ashleyjr/IceDAC/hardware/rev_a/IceDAC/IceDAC.kicad_pcb

## KiCad design hardware/rev_a/IceDAC/IceDAC.kicad_pcb (2024-07-18)

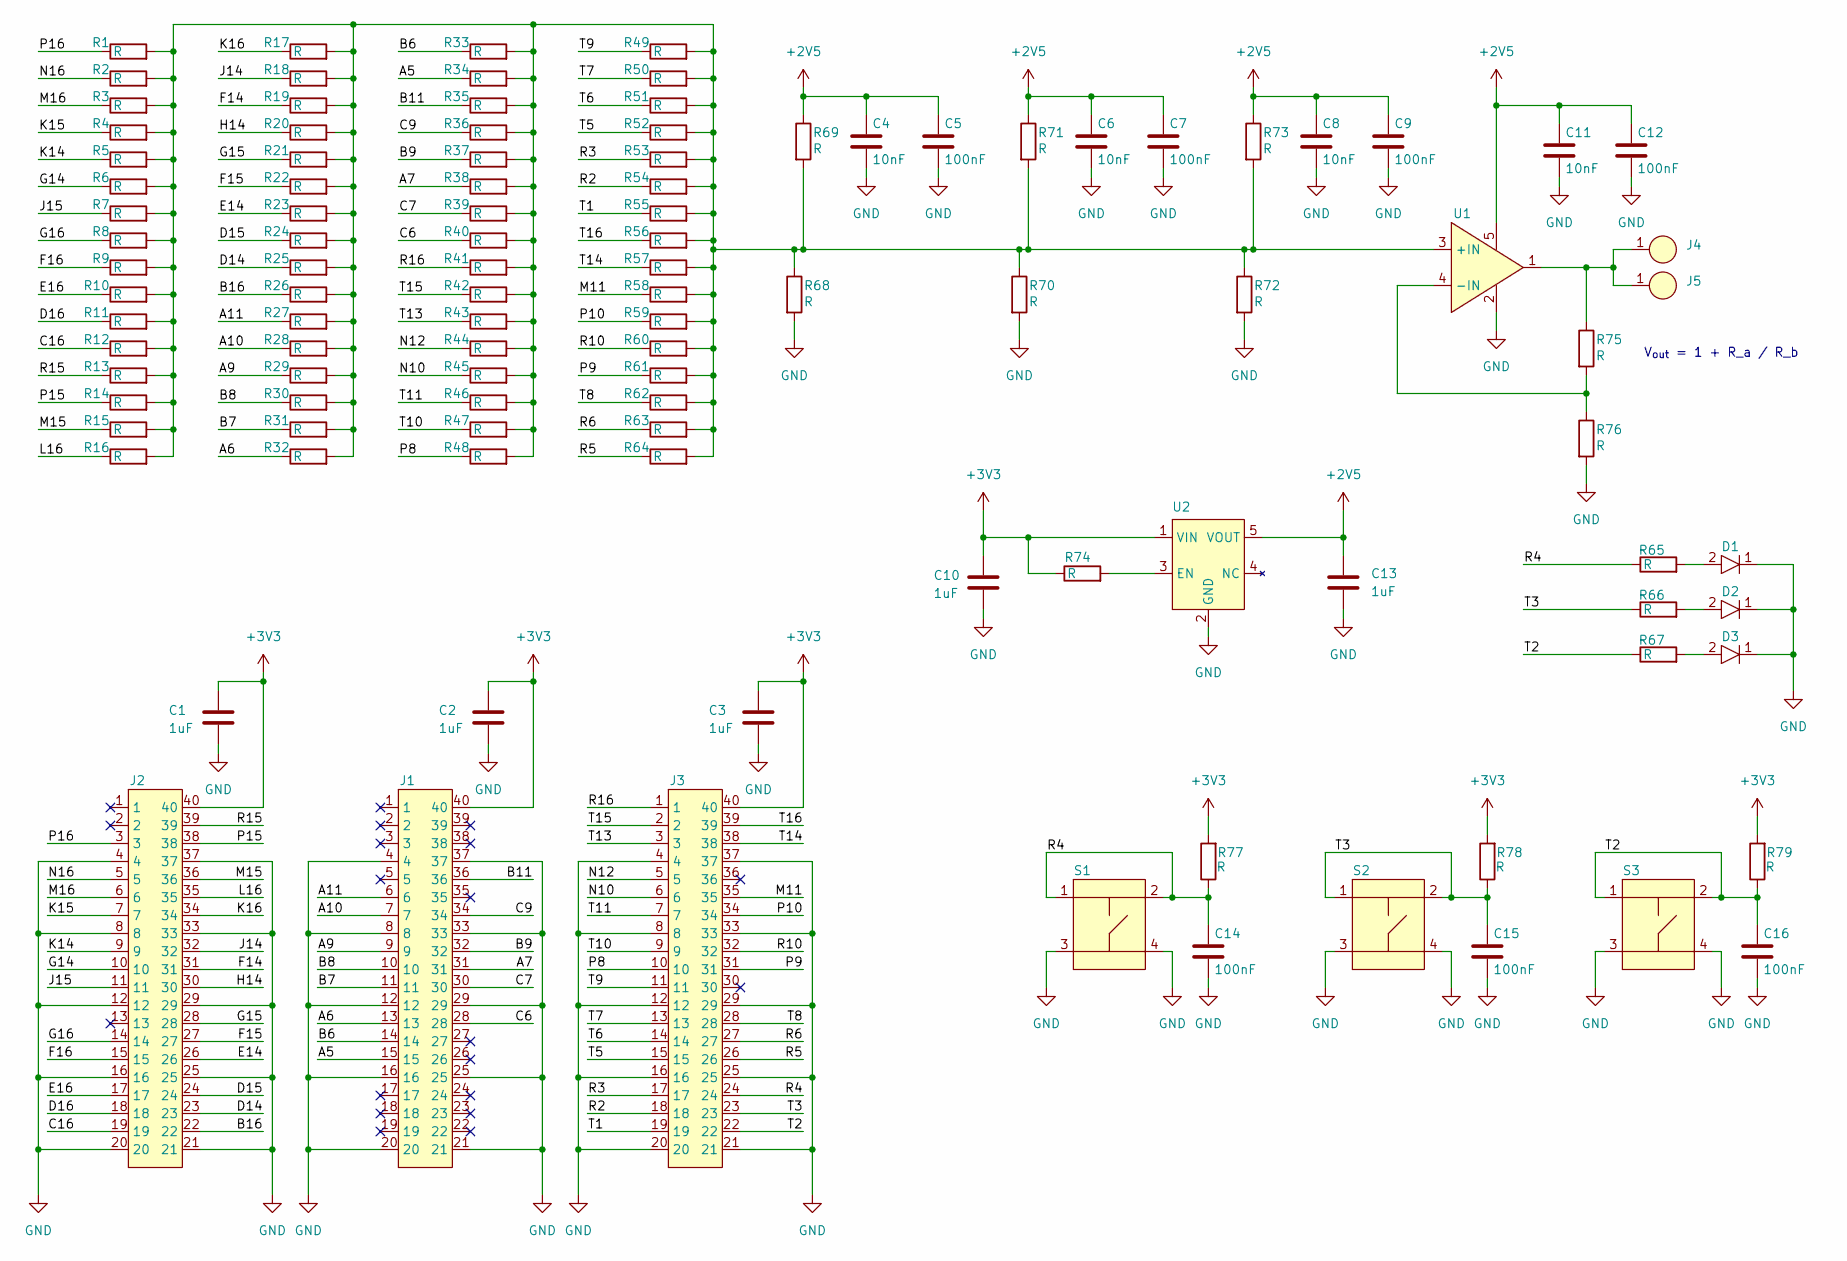
[picture p1: schematic IceDAC.kicad_sch]

Parts:
C1, C2, C3, C10, C13: 1uF; C_0603_1608Metric_Pad1.08x0.95mm_HandSolder
C4, C6, C8, C11: 10nF; C_0603_1608Metric_Pad1.08x0.95mm_HandSolder
C5, C7, C9, C12, C14, C15, C16: 100nF; C_0603_1608Metric_Pad1.08x0.95mm_HandSolder
D1, D2, D3: 150060GS75000
J1, J2, J3: M20-8761046
J4, J5: OUT
R1, R2, R3, R4, R5, R6, R7, R8, R9, R10, R11, R12, R13, R14, R15, R16, R17, R18, R19, R20, R21, R22, R23, R24, R25, R26, R27, R28, R29, R30, R31, R32, R33, R34, R35, R36, R37, R38, R39, R40, R41, R42, R43, R44, R45, R46, R47, R48, R49, R50, R51, R52, R53, R54, R55, R56, R57, R58, R59, R60, R61, R62, R63, R64, R65, R66, R67, R68, R69, R70, R71, R72, R73, R74, R75, R76, R77, R78, R79: R; R_0603_1608Metric_Pad0.98x0.95mm_HandSolder
S1, S2, S3: 1301.9315
U1: OPA354AIDBVR
U2: AP2112K-2.5TRG1

Connections:
+2V5: C4.1, C5.1, C6.1, C7.1, C8.1, C9.1, C11.1, C12.1, C13.1, R69.1, R71.1, R73.1, U1.5, U2.5 (VOUT)
+3V3: C1.1, C2.1, C3.1, C10.1, J1.40, J2.40, J3.40, R74.1, R77.2, R78.2, R79.2, U2.1 (VIN)
/A5: J1.15, R34.1
/A6: J1.13, R32.1
/A7: J1.31, R38.1
/A9: J1.9, R29.1
/A10: J1.7, R28.1
/A11: J1.6, R27.1
/B6: J1.14, R33.1
/B7: J1.11, R31.1
/B8: J1.10, R30.1
/B9: J1.32, R37.1
/B11: J1.36, R35.1
/B16: J2.22, R26.1
/C6: J1.28, R40.1
/C7: J1.30, R39.1
/C9: J1.34, R36.1
/C16: J2.19, R12.1
/D14: J2.23, R25.1
/D15: J2.24, R24.1
/D16: J2.18, R11.1
/E14: J2.26, R23.1
/E16: J2.17, R10.1
/F14: J2.31, R19.1
/F15: J2.27, R22.1
/F16: J2.15, R9.1
/G14: J2.10, R6.1
/G15: J2.28, R21.1
/G16: J2.14, R8.1
/H14: J2.30, R20.1
/J14: J2.32, R18.1
/J15: J2.11, R7.1
/K14: J2.9, R5.1
/K15: J2.7, R4.1
/K16: J2.34, R17.1
/L16: J2.35, R16.1
/M11: J3.35, R58.1
/M15: J2.36, R15.1
/M16: J2.6, R3.1
/N10: J3.6, R45.1
/N12: J3.5, R44.1
/N16: J2.5, R2.1
/P8: J3.10, R48.1
/P9: J3.31, R61.1
/P10: J3.34, R59.1
/P15: J2.38, R14.1
/P16: J2.3, R1.1
/R2: J3.18, R54.1
/R3: J3.17, R53.1
/R4: C14.1, J3.24, R65.1, R77.1, S1.1, S1.2
/R5: J3.26, R64.1
/R6: J3.27, R63.1
/R10: J3.32, R60.1
/R15: J2.39, R13.1
/R16: J3.1, R41.1
/T1: J3.19, R55.1
/T2: C16.1, J3.22, R67.1, R79.1, S3.1, S3.2
/T3: C15.1, J3.23, R66.1, R78.1, S2.1, S2.2
/T5: J3.15, R52.1
/T6: J3.14, R51.1
/T7: J3.13, R50.1
/T8: J3.28, R62.1
/T9: J3.11, R49.1
/T10: J3.9, R47.1
/T11: J3.7, R46.1
/T13: J3.3, R43.1
/T14: J3.38, R57.1
/T15: J3.2, R42.1
/T16: J3.39, R56.1
GND: C1.2, C2.2, C3.2, C4.2, C5.2, C6.2, C7.2, C8.2, C9.2, C10.2, C11.2, C12.2, C13.2, C14.2, C15.2, C16.2, D1.1, D2.1, D3.1, J1.4, J1.8, J1.12, J1.16, J1.20, J1.21, J1.25, J1.29, J1.33, J1.37, J2.4, J2.8, J2.12, J2.16, J2.20, J2.21, J2.25, J2.29, J2.33, J2.37, J3.4, J3.8, J3.12, J3.16, J3.20, J3.21, J3.25, J3.29, J3.33, J3.37, R68.2, R70.2, R72.2, R76.2, S1.3, S1.4, S2.3, S2.4, S3.3, S3.4, U1.2, U2.2 (GND)
unnamed: D1.2, R65.2
unnamed: D2.2, R66.2
unnamed: D3.2, R67.2
unnamed: J4.1, J5.1, R75.1, U1.1
unnamed: R1.2, R2.2, R3.2, R4.2, R5.2, R6.2, R7.2, R8.2, R9.2, R10.2, R11.2, R12.2, R13.2, R14.2, R15.2, R16.2, R17.2, R18.2, R19.2, R20.2, R21.2, R22.2, R23.2, R24.2, R25.2, R26.2, R27.2, R28.2, R29.2, R30.2, R31.2, R32.2, R33.2, R34.2, R35.2, R36.2, R37.2, R38.2, R39.2, R40.2, R41.2, R42.2, R43.2, R44.2, R45.2, R46.2, R47.2, R48.2, R49.2, R50.2, R51.2, R52.2, R53.2, R54.2, R55.2, R56.2, R57.2, R58.2, R59.2, R60.2, R61.2, R62.2, R63.2, R64.2, R68.1, R69.2, R70.1, R71.2, R72.1, R73.2, U1.3 (+IN)
unnamed: R75.2, R76.1, U1.4 (-IN)
unnamed: R74.2, U2.3 (EN)

Notes on the sheet:
V_{out} = 1 + R_a / R_b

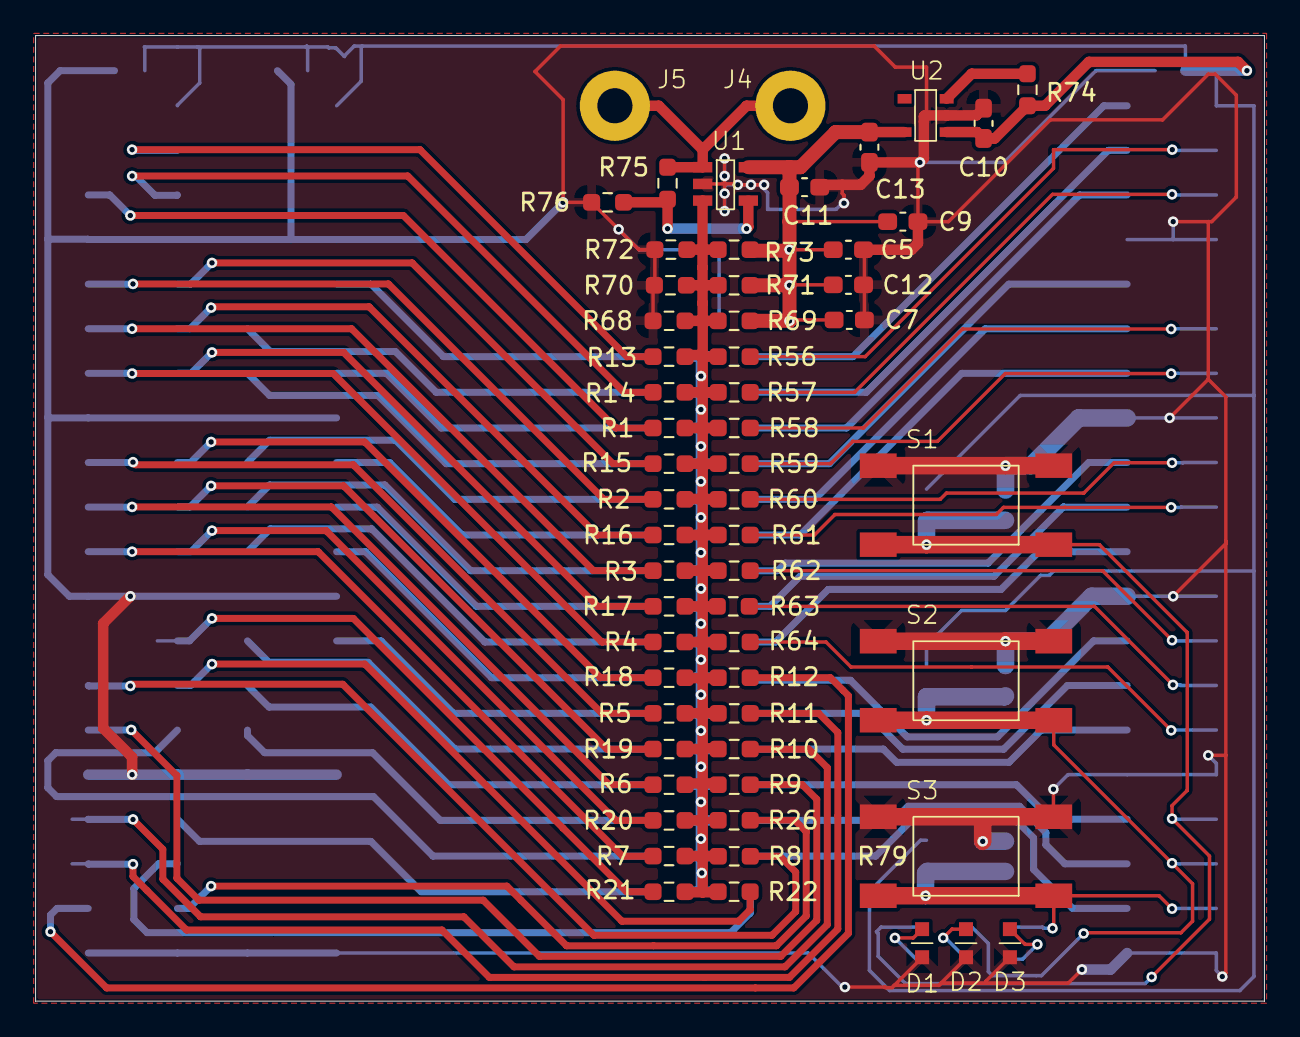
[picture p2: board IceDAC.kicad_pcb from above]

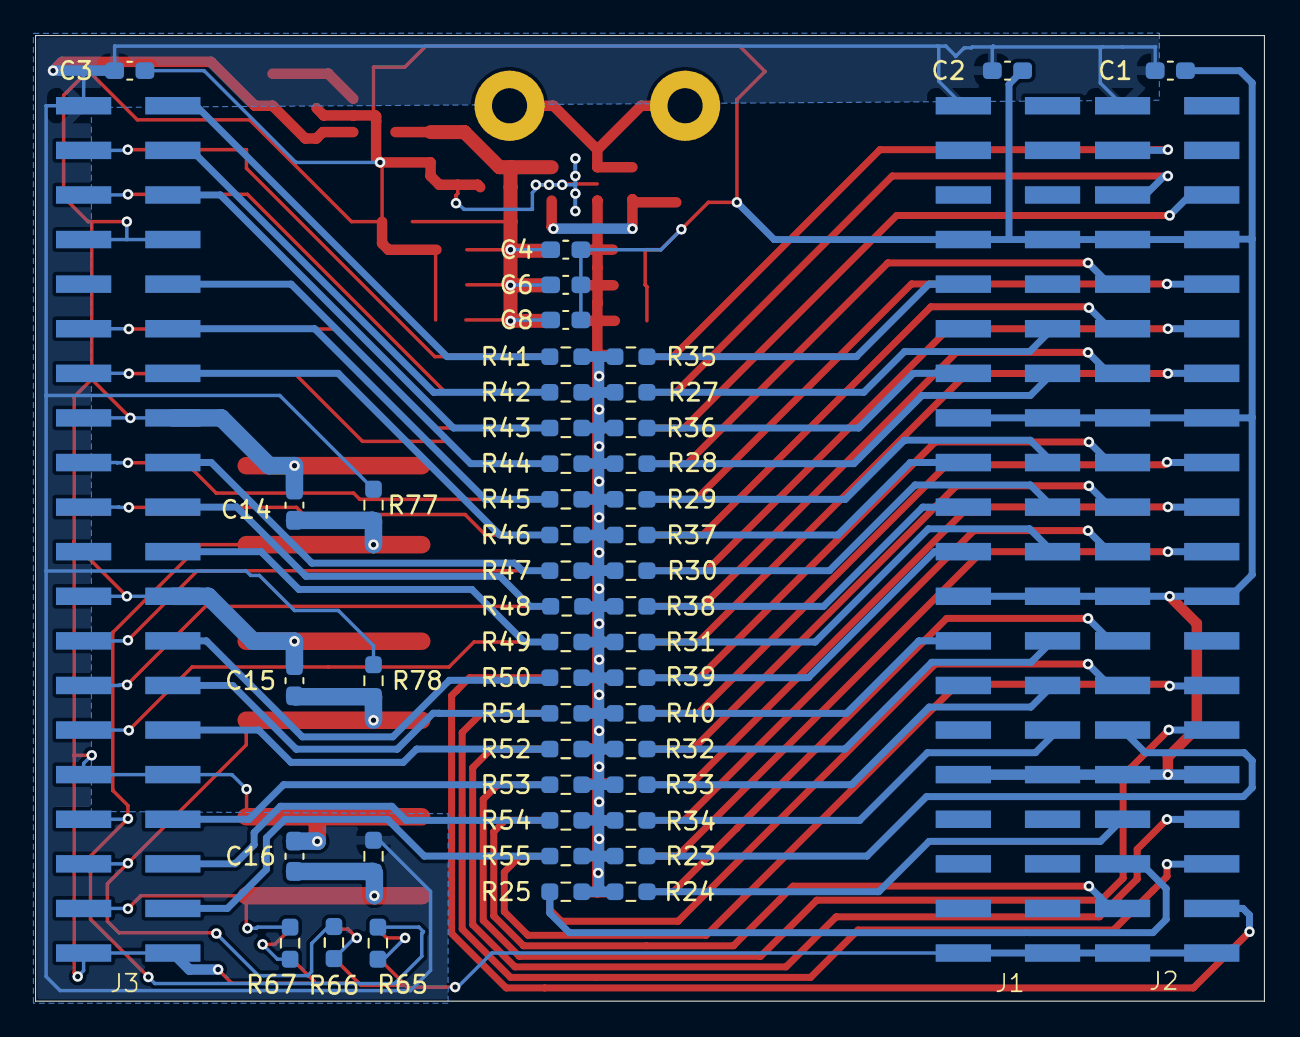
[picture p3: board IceDAC.kicad_pcb from below]

Board: 2 copper layers, 70.0 x 55.0 mm, 108 parts (47 on the bottom side), 77 nets.
