ashleyjr/IceDAC/(commit log)

2024-06-27 add uart submodule
2024-06-28 UART test
2024-07-18 rev a
    [IceDAC.kicad_pcb, IceDAC.kicad_sch]
